kakao16/KiCad9_Projects/XMOS_demo/doc/XMOS_demo.png

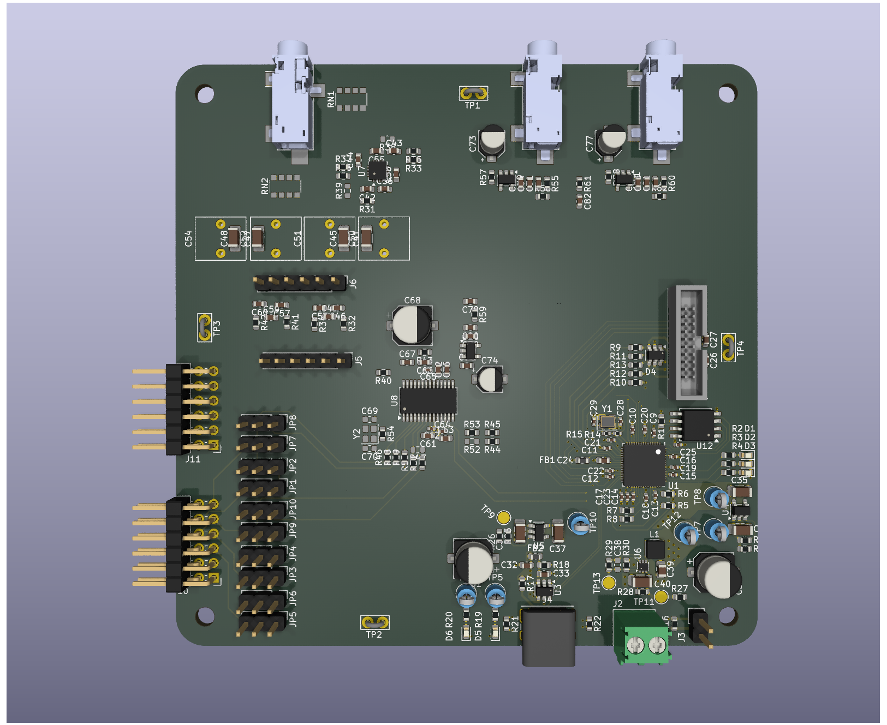
XMOS_demo/doc/XMOS_demo.png
