kakao16/KiCad9_Projects/XMOS_demo/sim/audio_out.asc

C1: cap; 470p
C2: cap; 2.7n
C3: cap; 2.7n
C4: cap; 470n
C5: cap; 470n
C6: cap; 2.7n
C7: cap; 2.7n
C8: cap; 470p
C9: cap; 2µ2
C10: cap; 2µ2
R1: res; 634R
R2: res; 634R
R3: res; 10k
R4: res; 10k
R5: res; 20k
R6: res; 20k
R7: res; 1k
R8: res; 634R
R9: res; 634R
R10: res; 10k
R11: res; 10k
R12: res; 20k
R13: res; 20k
R14: res; 1k
U1: UniversalOpAmp
U2: UniversalOpAmp
V1: voltage; ""; AC 1V
V2: voltage; 2.5V
V3: voltage; 5V
V4: voltage; ""; AC 1V
V5: voltage; 2.5V
Named nets: 0, P5V0, OUT1, OUT2
.ac dec 200 1 100k
Simplified AC simulation of analog output stage of XMOS_demo PCB
