kakao16/KiCad9_Projects/XMOS_demo/XMOS_demo.kicad_pcb

## KiCad design XMOS_demo/XMOS_demo.kicad_pcb (2026-10-02)

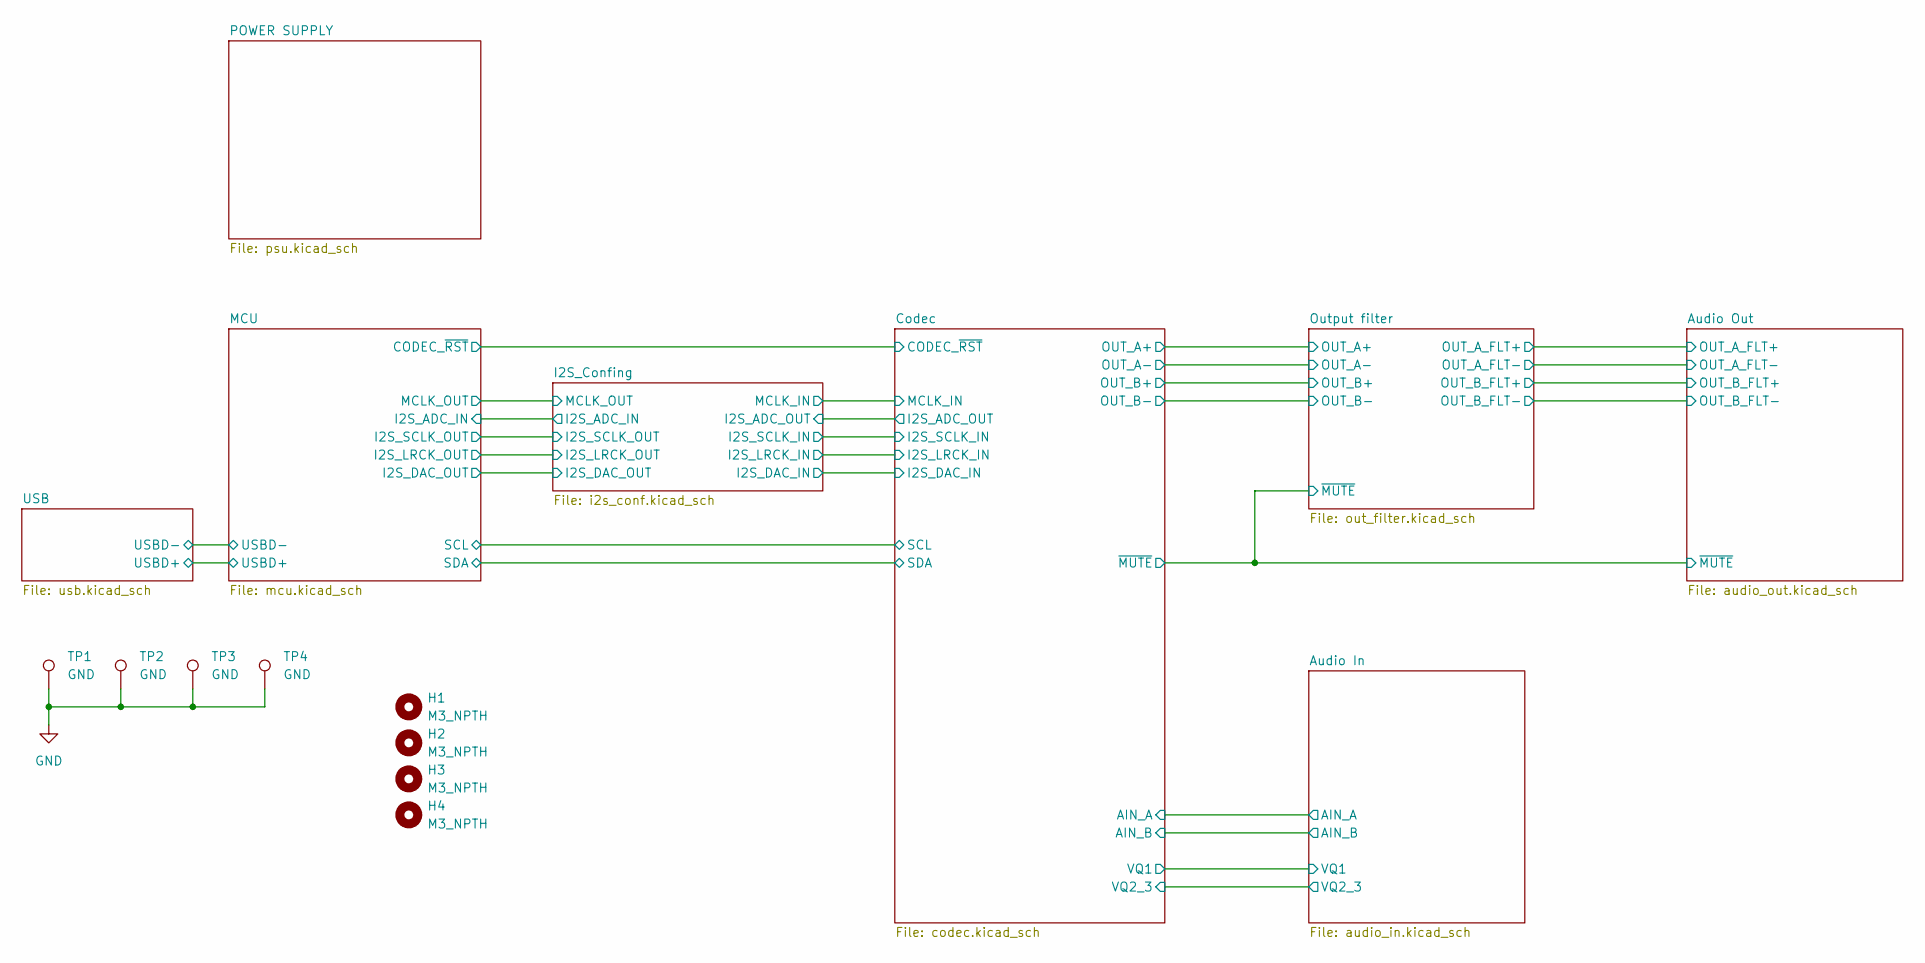
[picture p17: schematic XMOS_demo.kicad_sch, USB Sound Card Top Level]

Parts:
H1, H2, H3, H4: M3_NPTH; MountingHole_3.2mm_M3
TP1, TP2, TP3, TP4: GND; TestPoint_Bridge_Pitch2.54mm_Drill1.0mm

Connections:
GND: TP1.1, TP2.1, TP3.1, TP4.1; also elsewhere on the board

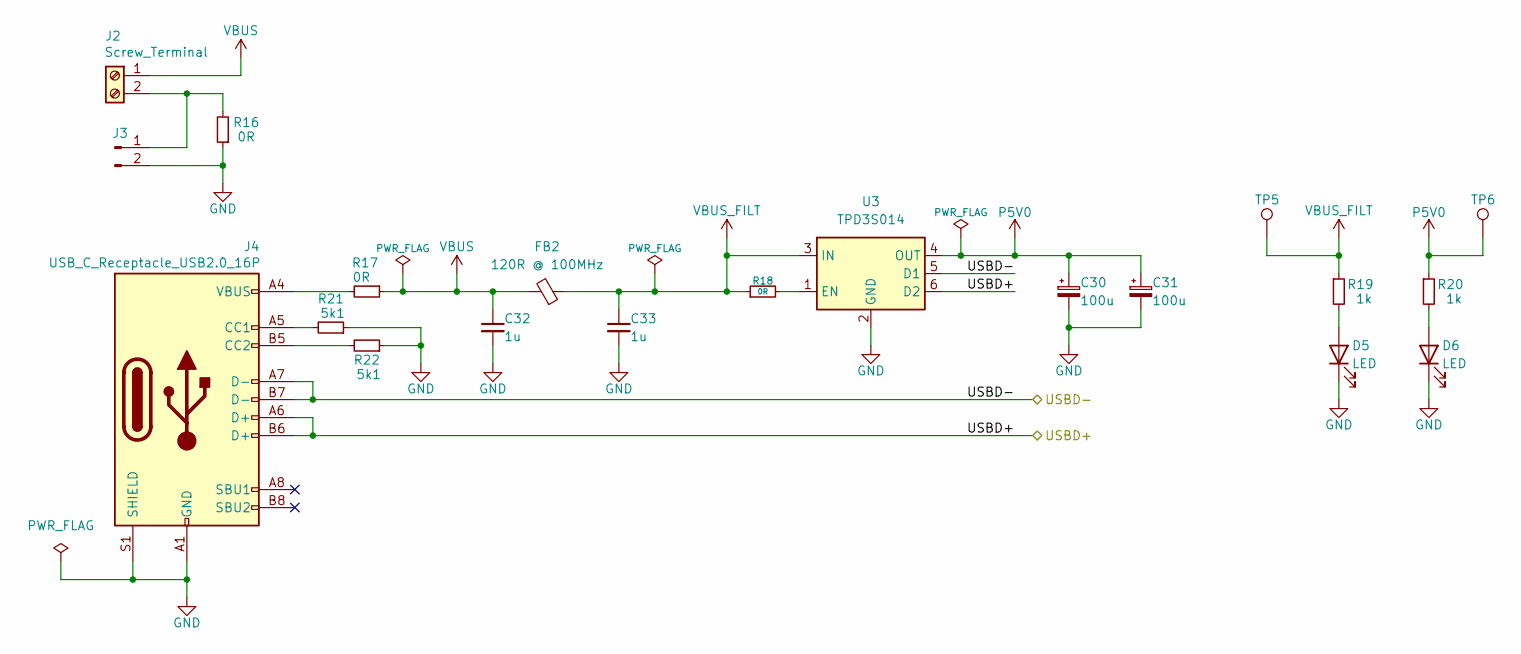
[picture p18: schematic usb.kicad_sch, USB Sound Card USB Port]

Parts:
C30, C31: 100u; CP_Elec_6.3x5.7
C32, C33: 1u; C_0603_1608Metric; Max Voltage 16V
D5, D6: LED; LED_0603_1608Metric
FB2: 120R @ 100MHz; L_0603_1608Metric; MPN MI0603M121R-10
J2: Screw_Terminal; TerminalBlock_Phoenix_PT-1,5-2-3.5-H_1x02_P3.50mm_Horizontal
J3: Conn_01x02_Pin; PinHeader_1x02_P2.54mm_Vertical
J4: USB_C_Receptacle_USB2.0_16P; USB_C_Receptacle_GCT_USB4085
R16, R17, R18: 0R; R_0603_1608Metric
R19, R20: 1k; R_0603_1608Metric
R21, R22: 5k1; R_0603_1608Metric
TP5, TP6: TestPoint; TestPoint_Keystone_5005-5009_Compact
U3: TPD3S014; SOT-23-6; MPN TPD3S014DBVR

Connections:
/USB/USBD+: J4.A6 (D+), J4.B6 (D+), U3.6 (D2); also elsewhere on the board
/USB/USBD-: J4.A7 (D-), J4.B7 (D-), U3.5 (D1); also elsewhere on the board
GND: C30.2, C31.2, C32.2, C33.2, D5.1 (K), D6.1 (K), J3.2, J4.A1 (GND), J4.A12 (GND), J4.B1 (GND), J4.B12 (GND), J4.S1 (SHIELD), R16.1, R21.1, R22.1, U3.2 (GND); also elsewhere on the board
unnamed: D5.2 (A), R19.2
unnamed: D6.2 (A), R20.2
unnamed: J2.2, J3.1, R16.2
unnamed: J4.A5 (CC1), R21.2
unnamed: J4.B5 (CC2), R22.2
unnamed: J4.A4 (VBUS), J4.A9 (VBUS), J4.B4 (VBUS), J4.B9 (VBUS), R17.2
unnamed: R18.2, U3.1 (EN)
P5V0: C30.1, C31.1, R20.1, TP6.1, U3.4 (OUT); also elsewhere on the board
VBUS: C32.1, FB2.2, J2.1, R17.1
VBUS_FILT: C33.1, FB2.1, R18.1, R19.1, TP5.1, U3.3 (IN)

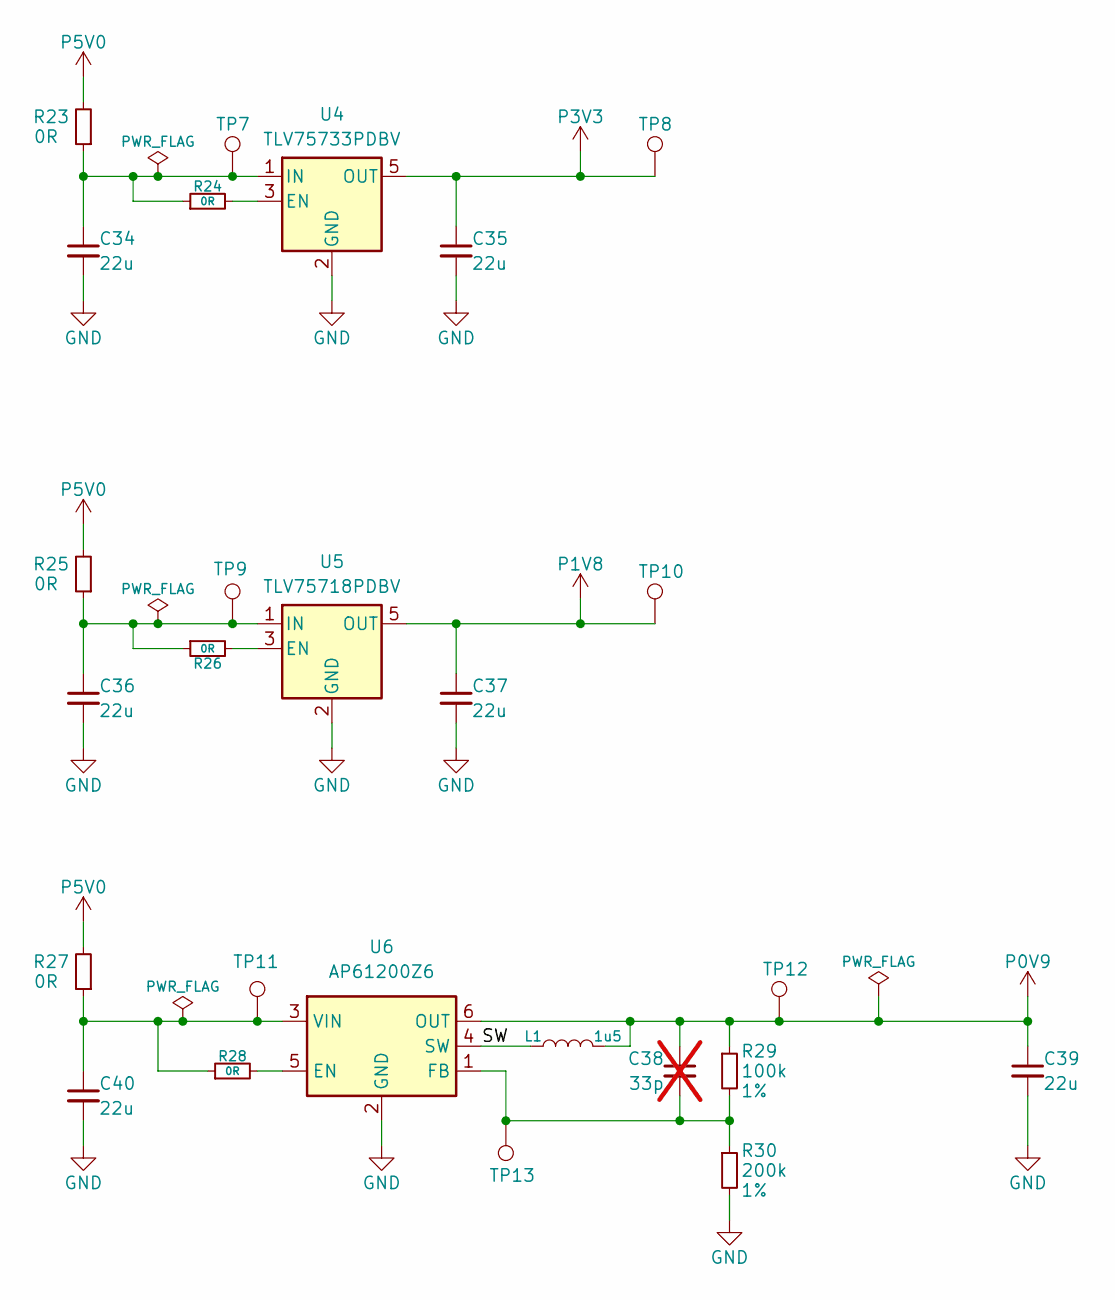
[picture p19: schematic psu.kicad_sch, USB Sound Card Power Supply]

Parts:
C34, C35, C36, C37, C40: 22u; C_1206_3216Metric; Max Voltage 16V
C38: 33p; C_0603_1608Metric; Max Voltage 10V; not fitted
C39: 22u; C_0805_2012Metric; Max Voltage 10V
L1: 1u5; L_Abracon_ASPI-3012S_3D_Simple; MPN ASPI-3012S-1R5N-T
R23, R24, R25, R26, R27, R28: 0R; R_0603_1608Metric
R29: 100k; R_0603_1608Metric; Tolerance 1%
R30: 200k; R_0603_1608Metric; Tolerance 1%
TP7, TP9, TP11, TP13: TestPoint; TestPoint_Pad_D2.0mm
TP8, TP10, TP12: TestPoint; TestPoint_Keystone_5005-5009_Compact
U4: TLV75733PDBV; SOT-23-5
U5: TLV75718PDBV; SOT-23-5
U6: AP61200Z6; SOT-563

Connections:
/POWER SUPPLY/SW: L1.1, U6.4 (SW)
GND: C34.2, C35.2, C36.2, C37.2, C39.2, C40.2, R30.2, U4.2 (GND), U5.2 (GND), U6.2 (GND); also elsewhere on the board
unnamed: R24.2, U4.3 (EN)
unnamed: C34.1, R23.1, R24.1, TP7.1, U4.1 (IN)
unnamed: R26.2, U5.3 (EN)
unnamed: C36.1, R25.1, R26.1, TP9.1, U5.1 (IN)
unnamed: R28.2, U6.5 (EN)
unnamed: C38.2, R29.2, R30.1, TP13.1, U6.1 (FB)
unnamed: C40.1, R27.1, R28.1, TP11.1, U6.3 (VIN)
P0V9: C38.1, C39.1, L1.2, R29.1, TP12.1, U6.6 (OUT); also elsewhere on the board
P1V8: C37.1, TP10.1, U5.5 (OUT); also elsewhere on the board
P3V3: C35.1, TP8.1, U4.5 (OUT); also elsewhere on the board
P5V0: R23.2, R25.2, R27.2; also elsewhere on the board

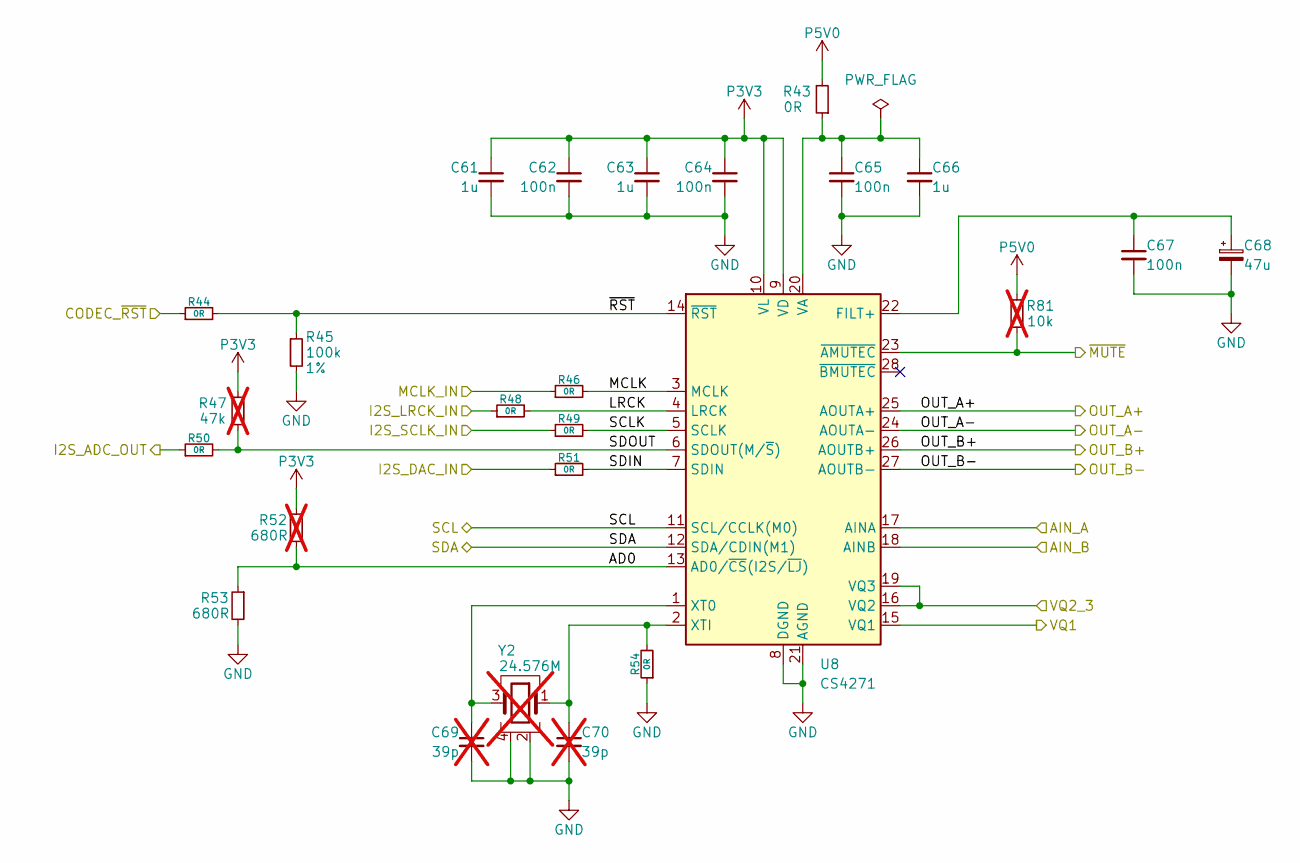
[picture p20: schematic codec.kicad_sch, USB Sound Card Audio Codec]

Parts:
C61, C63, C66: 1u; C_0603_1608Metric; Max Voltage 16V
C62, C64, C65: 100n; C_0402_1005Metric; Max Voltage 16V
C67: 100n; C_0603_1608Metric; Max Voltage 16V
C68: 47u; CP_Elec_6.3x5.7
C69, C70: 39p; C_0603_1608Metric; Max Voltage 10V; not fitted
R43, R44, R46, R48, R49, R50, R51, R54: 0R; R_0603_1608Metric
R45: 100k; R_0603_1608Metric; Tolerance 1%
R47: 47k; R_0603_1608Metric; not fitted
R52: 680R; R_0603_1608Metric; not fitted
R53: 680R; R_0603_1608Metric
R81: 10k; R_0603_1608Metric; not fitted
U8: CS4271; TSSOP-28_4.4x9.7mm_P0.65mm
Y2: 24.576M; Crystal_SMD_2520-4Pin_2.5x2.0mm; not fitted

Connections:
/Audio In/AIN_A: U8.17 (AINA); also elsewhere on the board
/Audio In/AIN_B: U8.18 (AINB); also elsewhere on the board
/Audio In/VQ1: U8.15 (VQ1); also elsewhere on the board
/Audio In/VQ2_3: U8.16 (VQ2), U8.19 (VQ3); also elsewhere on the board
/Audio Out/~MUTE: R81.2, U8.23 (~AMUTEC); also elsewhere on the board
/Codec/AD0: R52.2, R53.1, U8.13 (AD0/~CS(I2S/~LJ))
/Codec/I2S_ADC_OUT: R50.1; also elsewhere on the board
/Codec/I2S_DAC_IN: R51.1; also elsewhere on the board
/Codec/I2S_LRCK_IN: R48.1; also elsewhere on the board
/Codec/I2S_SCLK_IN: R49.1; also elsewhere on the board
/Codec/LRCK: R48.2, U8.4 (LRCK)
/Codec/MCLK: R46.2, U8.3 (MCLK)
/Codec/MCLK_IN: R46.1; also elsewhere on the board
/Codec/OUT_A+: U8.25 (AOUTA+); also elsewhere on the board
/Codec/OUT_A-: U8.24 (AOUTA-); also elsewhere on the board
/Codec/OUT_B+: U8.26 (AOUTB+); also elsewhere on the board
/Codec/OUT_B-: U8.27 (AOUTB-); also elsewhere on the board
/Codec/SCL: U8.11 (SCL/CCLK(M0)); also elsewhere on the board
/Codec/SCLK: R49.2, U8.5 (SCLK)
/Codec/SDA: U8.12 (SDA/CDIN(M1)); also elsewhere on the board
/Codec/SDIN: R51.2, U8.7 (SDIN)
/Codec/SDOUT: R47.2, R50.2, U8.6 (SDOUT(M/~S))
/Codec/~RST: R44.2, R45.1, U8.14 (~RST)
/MCU/CODEC_~RST: R44.1; also elsewhere on the board
GND: C61.2, C62.2, C63.2, C64.2, C65.2, C66.2, C67.2, C68.2, C69.2, C70.2, R45.2, R53.2, R54.1, U8.8 (DGND), U8.21 (AGND), Y2.2 (G), Y2.4 (G); also elsewhere on the board
unnamed: C67.1, C68.1, U8.22 (FILT+)
unnamed: C65.1, C66.1, R43.1, U8.20 (VA)
unnamed: C69.1, U8.1 (XT0), Y2.3
unnamed: C70.1, R54.2, U8.2 (XTI), Y2.1
P3V3: C61.1, C62.1, C63.1, C64.1, R47.1, R52.1, U8.9 (VD), U8.10 (VL); also elsewhere on the board
P5V0: R43.2, R81.1; also elsewhere on the board

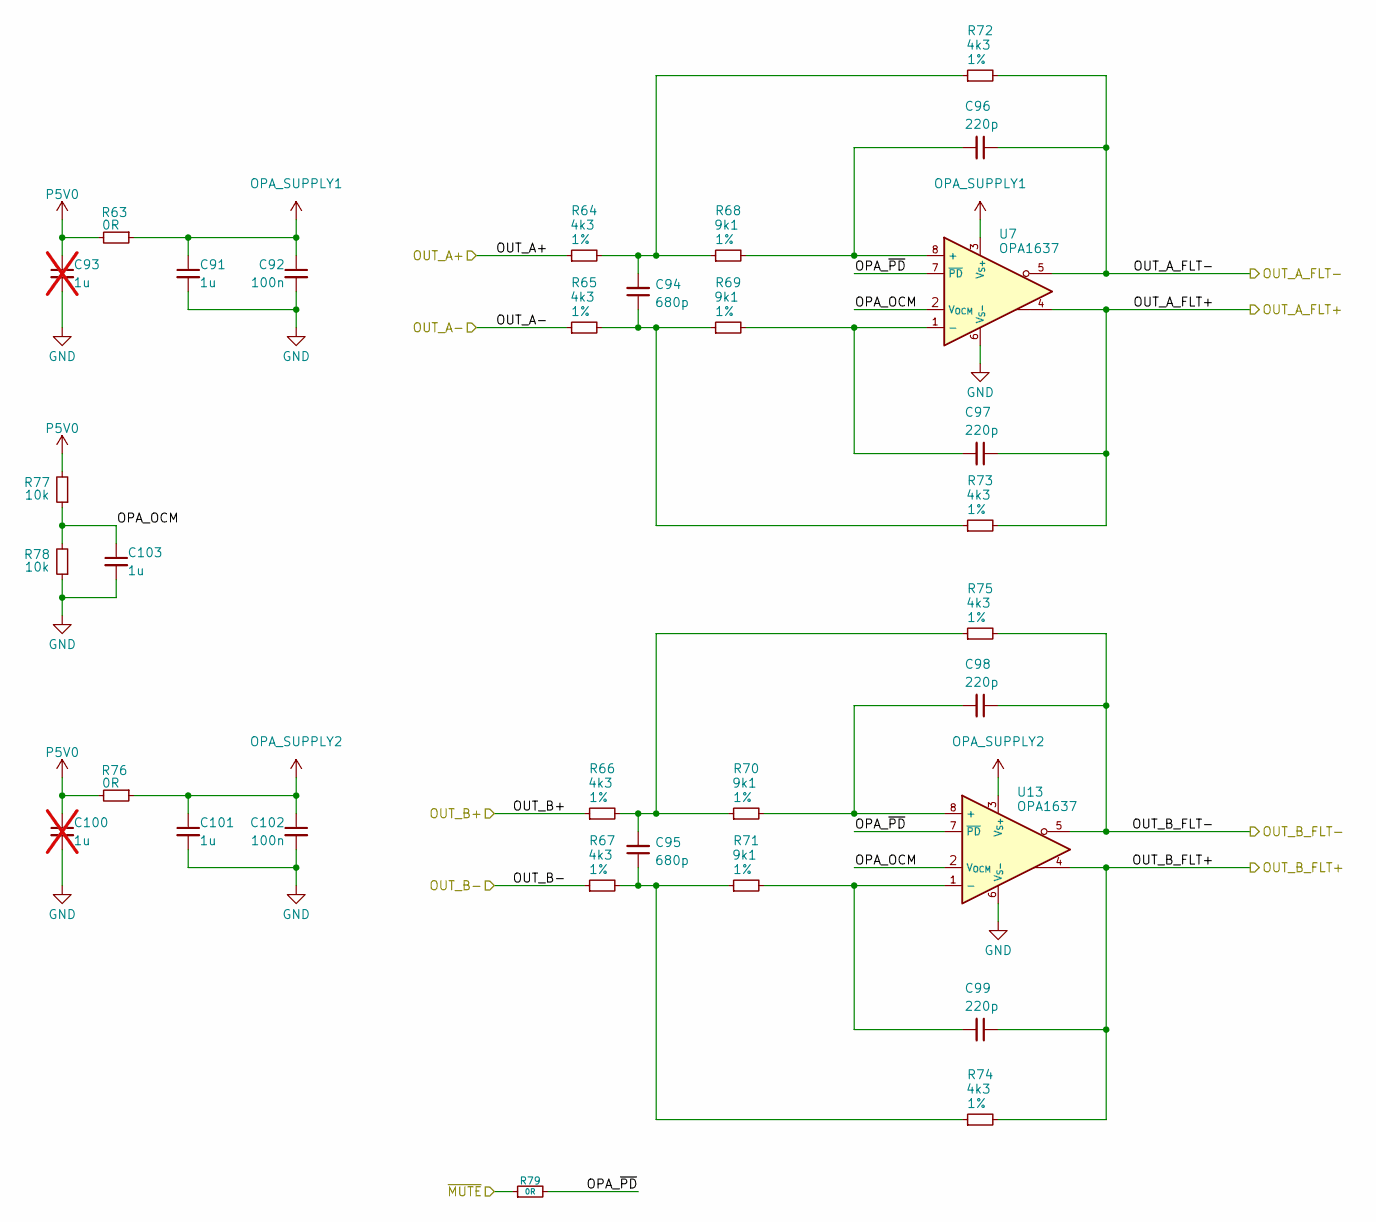
[picture p21: schematic out_filter.kicad_sch]

Parts:
C91, C101, C103: 1u; C_0603_1608Metric; Max Voltage 16V
C92, C102: 100n; C_0402_1005Metric; Max Voltage 16V
C93, C100: 1u; C_0603_1608Metric; Max Voltage 16V; not fitted
C94, C95: 680p; C_0603_1608Metric; Max Voltage 25V
C96, C97, C98, C99: 220p; C_0603_1608Metric; Max Voltage 25V
R63, R76, R79: 0R; R_0603_1608Metric
R64, R65, R66, R67, R72, R73, R74, R75: 4k3; R_0603_1608Metric; Tolerance 1%
R68, R69, R70, R71: 9k1; R_0603_1608Metric; Tolerance 1%
R77, R78: 10k; R_0603_1608Metric
U7, U13: OPA1637; VSSOP-8_3x3mm_P0.65mm; MPN OPA1637DGKR

Connections:
/Audio Out/OUT_A_FLT+: C97.1, R73.2, U7.4; also elsewhere on the board
/Audio Out/OUT_A_FLT-: C96.1, R72.2, U7.5; also elsewhere on the board
/Audio Out/OUT_B_FLT+: C99.1, R74.2, U13.4; also elsewhere on the board
/Audio Out/OUT_B_FLT-: C98.1, R75.2, U13.5; also elsewhere on the board
/Audio Out/~MUTE: R79.1; also elsewhere on the board
/Codec/OUT_A+: R64.1; also elsewhere on the board
/Codec/OUT_A-: R65.1; also elsewhere on the board
/Codec/OUT_B+: R66.1; also elsewhere on the board
/Codec/OUT_B-: R67.1; also elsewhere on the board
/Output filter/OPA_OCM: C103.1, R77.1, R78.2, U7.2 (V_{OCM}), U13.2 (V_{OCM})
/Output filter/OPA_~PD: R79.2, U7.7 (~PD), U13.7 (~PD)
GND: C91.2, C92.2, C93.2, C100.2, C101.2, C102.2, C103.2, R78.1, U7.6 (V_{S-}), U13.6 (V_{S-}); also elsewhere on the board
unnamed: C94.1, R65.2, R69.1, R73.1
unnamed: C94.2, R64.2, R68.1, R72.1
unnamed: C95.1, R67.2, R71.1, R74.1
unnamed: C95.2, R66.2, R70.1, R75.1
unnamed: C96.2, R68.2, U7.8 (+)
unnamed: C97.2, R69.2, U7.1 (-)
unnamed: C98.2, R70.2, U13.8 (+)
unnamed: C99.2, R71.2, U13.1 (-)
OPA_SUPPLY1: C91.1, C92.1, R63.1, U7.3 (V_{S+})
OPA_SUPPLY2: C101.1, C102.1, R76.1, U13.3 (V_{S+})
P5V0: C93.1, C100.1, R63.2, R76.2, R77.2; also elsewhere on the board

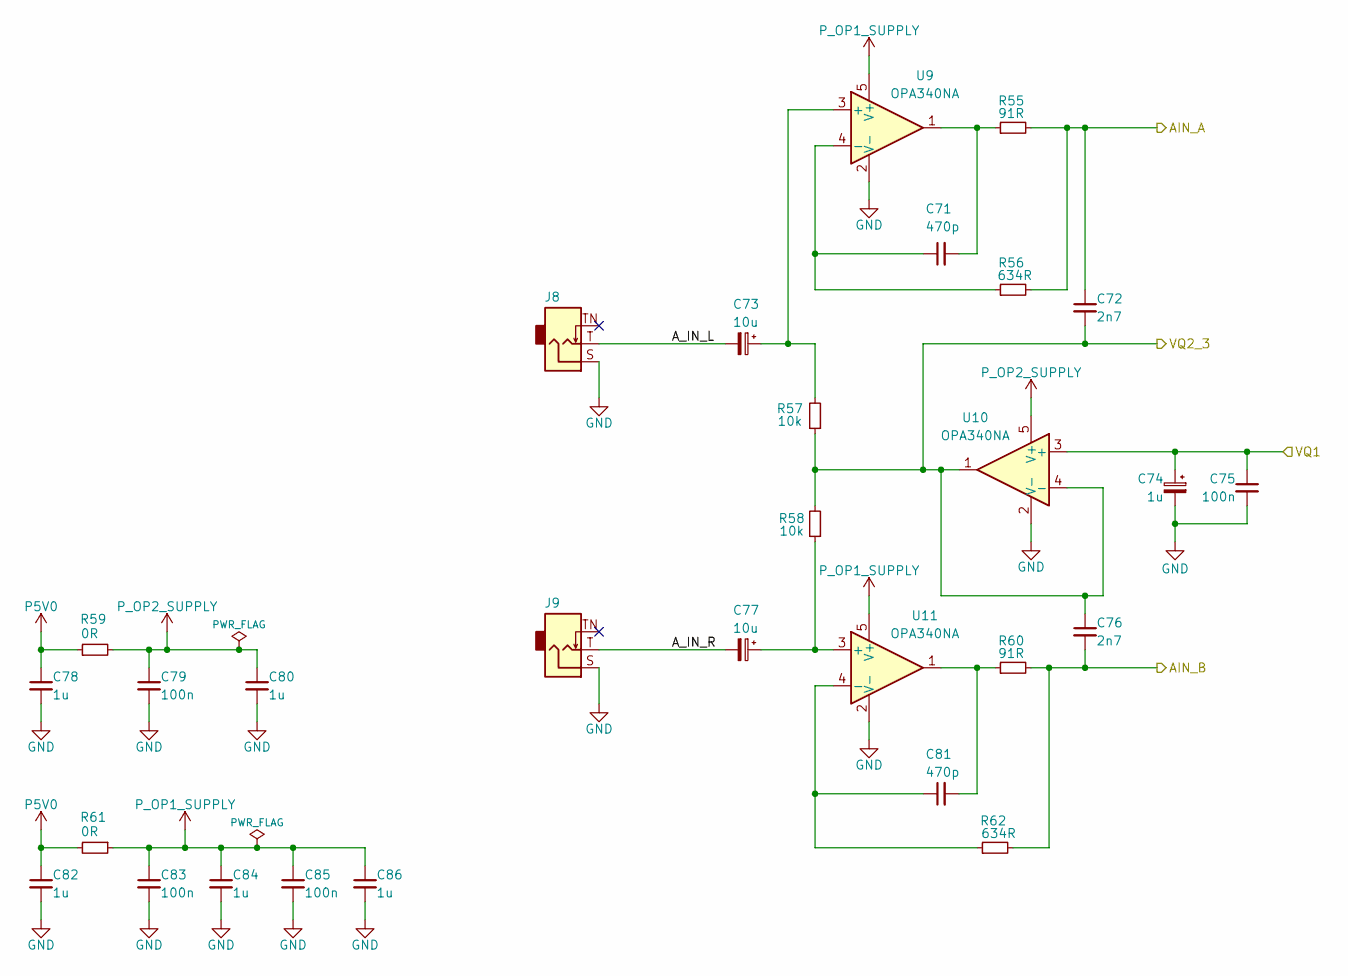
[picture p22: schematic audio_in.kicad_sch, USB Sound Card Audio Input]

Parts:
C71, C81: 470p; C_0603_1608Metric; Max Voltage 25V
C72, C76: 2n7; C_0603_1608Metric; Max Voltage 25V
C73, C77: 10u; CP_Elec_4x5.4
C74: 1u; CP_Elec_4x5.4
C75, C79, C83, C85: 100n; C_0603_1608Metric; Max Voltage 16V
C78, C80, C82, C84, C86: 1u; C_0603_1608Metric; Max Voltage 16V
J8, J9: AudioJack2_SwitchT; Jack_3.5mm_CUI_MJ-3523-SMT-TR_Horizontal; MPN MJ-3523-SMT-TR
R55, R60: 91R; R_0603_1608Metric
R56, R62: 634R; R_0603_1608Metric
R57, R58: 10k; R_0603_1608Metric
R59, R61: 0R; R_0603_1608Metric
U9, U10, U11: OPA340NA; SOT-23-5

Connections:
/Audio In/AIN_A: C72.1, R55.2, R56.2; also elsewhere on the board
/Audio In/AIN_B: C76.2, R60.2, R62.2; also elsewhere on the board
/Audio In/A_IN_L: C73.2, J8.T
/Audio In/A_IN_R: C77.2, J9.T
/Audio In/VQ1: C74.1, C75.1, U10.3 (+); also elsewhere on the board
/Audio In/VQ2_3: C72.2, C76.1, R57.1, R58.2, U10.1, U10.4 (-); also elsewhere on the board
GND: C74.2, C75.2, C78.2, C79.2, C80.2, C82.2, C83.2, C84.2, C85.2, C86.2, J8.S, J9.S, U9.2 (V-), U10.2 (V-), U11.2 (V-); also elsewhere on the board
unnamed: C71.2, R55.1, U9.1
unnamed: C81.2, R60.1, U11.1
unnamed: C73.1, R57.2, U9.3 (+)
unnamed: C71.1, R56.1, U9.4 (-)
unnamed: C77.1, R58.1, U11.3 (+)
unnamed: C81.1, R62.1, U11.4 (-)
P5V0: C78.1, C82.1, R59.1, R61.2; also elsewhere on the board
P_OP1_SUPPLY: C83.1, C84.1, C85.1, C86.1, R61.1, U9.5 (V+), U11.5 (V+)
P_OP2_SUPPLY: C79.1, C80.1, R59.2, U10.5 (V+)

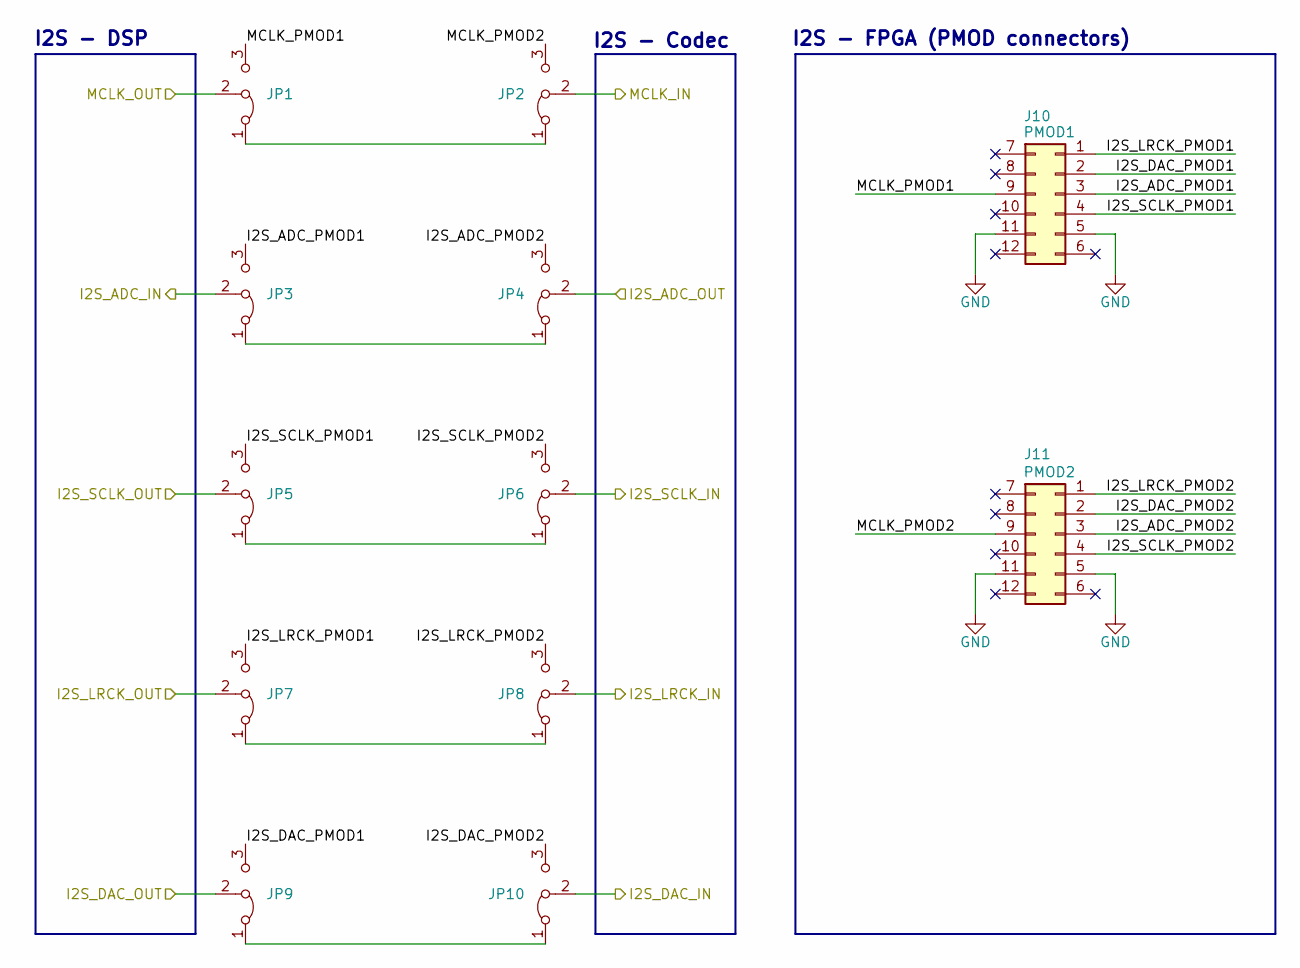
[picture p23: schematic i2s_conf.kicad_sch, USB Sound Card I2S Configuration]

Parts:
J10, J11: Conn_PMOD_02x06; PMOD_PinHeader_2x06_P2.54mm_Horizontal
JP1, JP2, JP3, JP4, JP5, JP6, JP7, JP8, JP9, JP10: Jumper_3_Bridged12; PinHeader_1x03_P2.54mm_Vertical

Connections:
/Codec/I2S_ADC_OUT: JP4.2 (C); also elsewhere on the board
/Codec/I2S_DAC_IN: JP10.2 (C); also elsewhere on the board
/Codec/I2S_LRCK_IN: JP8.2 (C); also elsewhere on the board
/Codec/I2S_SCLK_IN: JP6.2 (C); also elsewhere on the board
/Codec/MCLK_IN: JP2.2 (C); also elsewhere on the board
/I2S_Confing/I2S_ADC_PMOD1: J10.3, JP3.3 (B)
/I2S_Confing/I2S_ADC_PMOD2: J11.3, JP4.3 (B)
/I2S_Confing/I2S_DAC_PMOD1: J10.2, JP9.3 (B)
/I2S_Confing/I2S_DAC_PMOD2: J11.2, JP10.3 (B)
/I2S_Confing/I2S_LRCK_PMOD1: J10.1, JP7.3 (B)
/I2S_Confing/I2S_LRCK_PMOD2: J11.1, JP8.3 (B)
/I2S_Confing/I2S_SCLK_PMOD1: J10.4, JP5.3 (B)
/I2S_Confing/I2S_SCLK_PMOD2: J11.4, JP6.3 (B)
/I2S_Confing/MCLK_PMOD1: J10.9, JP1.3 (B)
/I2S_Confing/MCLK_PMOD2: J11.9, JP2.3 (B)
/MCU/I2S_ADC_IN: JP3.2 (C); also elsewhere on the board
/MCU/I2S_DAC_OUT: JP9.2 (C); also elsewhere on the board
/MCU/I2S_LRCK_OUT: JP7.2 (C); also elsewhere on the board
/MCU/I2S_SCLK_OUT: JP5.2 (C); also elsewhere on the board
/MCU/MCLK_OUT: JP1.2 (C); also elsewhere on the board
GND: J10.5, J10.11, J11.5, J11.11; also elsewhere on the board
unnamed: JP1.1 (A), JP2.1 (A)
unnamed: JP3.1 (A), JP4.1 (A)
unnamed: JP5.1 (A), JP6.1 (A)
unnamed: JP7.1 (A), JP8.1 (A)
unnamed: JP9.1 (A), JP10.1 (A)

Notes on the sheet:
I2S - DSP
I2S - FPGA (PMOD connectors)
I2S - Codec

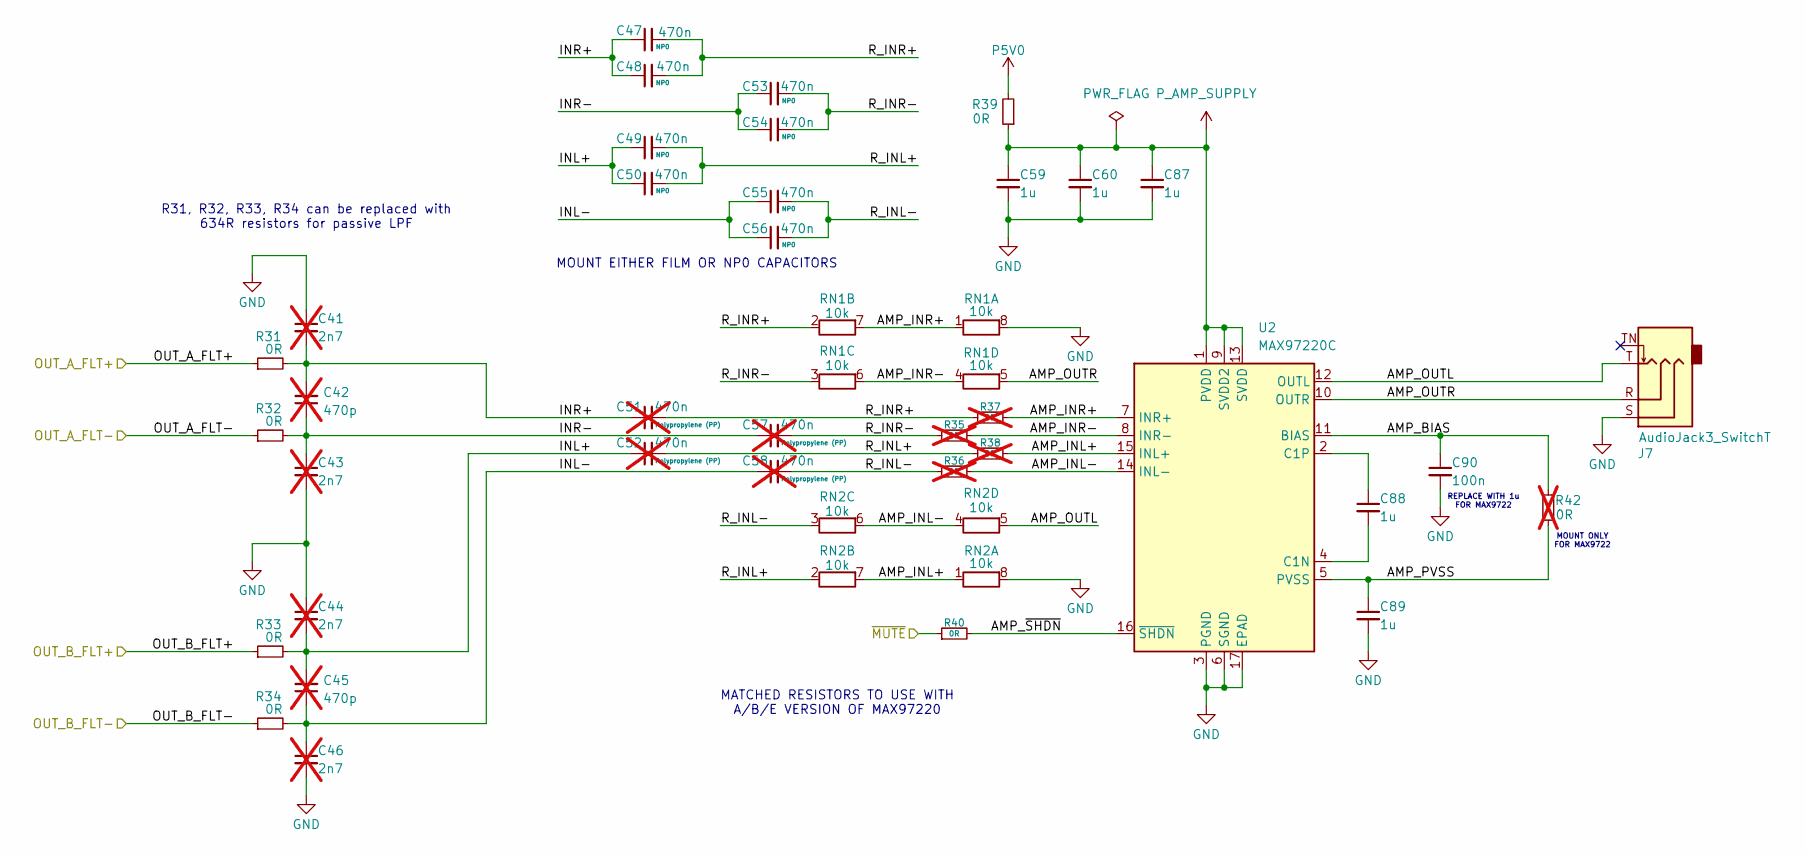
[picture p24: schematic audio_out.kicad_sch, USB Sound Card Audio Output Amplifier]

Parts:
C41, C43, C44, C46: 2n7; C_0603_1608Metric; Max Voltage 25V; not fitted
C42, C45: 470p; C_0603_1608Metric; Max Voltage 25V; not fitted
C47, C48, C49, C50, C53, C54, C55, C56: 470n; C_1206_3216Metric_Pad1.33x1.80mm_HandSolder; Max Voltage 25V; MPN GRM31C5C1E474JE01L
C51, C52, C57, C58: 470n; C_Rect_L7.2mm_W8.5mm_P5.00mm_FKP2_FKP2_MKS2_MKP2; Max Voltage DC 100V; MPN MKP2D034701M00KSSD; not fitted
C59, C60, C87, C88, C89: 1u; C_0603_1608Metric; Max Voltage 16V
C90: 100n; C_0402_1005Metric; Max Voltage 16V
J7: AudioJack3_SwitchT; Jack_3.5mm_CUI_SJ-3523-SMT-TR_Horizontal; MPN SJ-3523-SMT-TR
R31, R32, R33, R34, R39, R40: 0R; R_0603_1608Metric
R35, R36, R37, R38, R42: 0R; R_0603_1608Metric; not fitted
RN1, RN2: 10k; R_Array_Convex_4x0603
U2: MAX97220C; TQFN-16-1EP_3x3mm_P0.5mm_EP1.23x1.23mm_ThermalVias

Connections:
/Audio Out/AMP_BIAS: C90.1, R42.2, U2.11 (BIAS)
/Audio Out/AMP_INL+: R38.2, RN2.1 (R1.1), RN2.7 (R2.2), U2.15 (INL+)
/Audio Out/AMP_INL-: R36.2, RN2.4 (R4.1), RN2.6 (R3.2), U2.14 (INL-)
/Audio Out/AMP_INR+: R37.2, RN1.1 (R1.1), RN1.7 (R2.2), U2.7 (INR+)
/Audio Out/AMP_INR-: R35.2, RN1.4 (R4.1), RN1.6 (R3.2), U2.8 (INR-)
/Audio Out/AMP_OUTL: J7.T, RN2.5 (R4.2), U2.12 (OUTL)
/Audio Out/AMP_OUTR: J7.R, RN1.5 (R4.2), U2.10 (OUTR)
/Audio Out/AMP_PVSS: C89.1, R42.1, U2.5 (PVSS)
/Audio Out/AMP_~SHDN: R40.2, U2.16 (~SHDN)
/Audio Out/INL+: C44.2, C45.2, C49.1, C50.1, C52.1, R33.2
/Audio Out/INL-: C45.1, C46.1, C55.1, C56.1, C58.1, R34.2
/Audio Out/INR+: C41.2, C42.2, C47.1, C48.1, C51.1, R31.2
/Audio Out/INR-: C42.1, C43.1, C53.1, C54.1, C57.1, R32.2
/Audio Out/OUT_A_FLT+: R31.1; also elsewhere on the board
/Audio Out/OUT_A_FLT-: R32.1; also elsewhere on the board
/Audio Out/OUT_B_FLT+: R33.1; also elsewhere on the board
/Audio Out/OUT_B_FLT-: R34.1; also elsewhere on the board
/Audio Out/R_INL+: C49.2, C50.2, C52.2, R38.1, RN2.2 (R2.1)
/Audio Out/R_INL-: C55.2, C56.2, C58.2, R36.1, RN2.3 (R3.1)
/Audio Out/R_INR+: C47.2, C48.2, C51.2, R37.1, RN1.2 (R2.1)
/Audio Out/R_INR-: C53.2, C54.2, C57.2, R35.1, RN1.3 (R3.1)
/Audio Out/~MUTE: R40.1; also elsewhere on the board
GND: C41.1, C43.2, C44.1, C46.2, C59.2, C60.2, C87.2, C89.2, C90.2, J7.S, RN1.8 (R1.2), RN2.8 (R1.2), U2.3 (PGND), U2.6 (SGND), U2.17 (EPAD); also elsewhere on the board
unnamed: C88.2, U2.4 (C1N)
unnamed: C88.1, U2.2 (C1P)
P5V0: R39.2; also elsewhere on the board
P_AMP_SUPPLY: C59.1, C60.1, C87.1, R39.1, U2.1 (PVDD), U2.9 (SVDD2), U2.13 (SVDD)

Notes on the sheet:
R31, R32, R33, R34 can be replaced with 634R resistors for passive LPF
MOUNT EITHER FILM OR NP0 CAPACITORS
MOUNT ONLY FOR MAX9722
MATCHED RESISTORS TO USE WITH A/B/E VERSION OF MAX97220
REPLACE WITH 1u FOR MAX9722
