kakao16/KiCad9_Projects/XMOS_demo/XMOS_demo.kicad_pcb

## KiCad design XMOS_demo/XMOS_demo.kicad_pcb (continued)

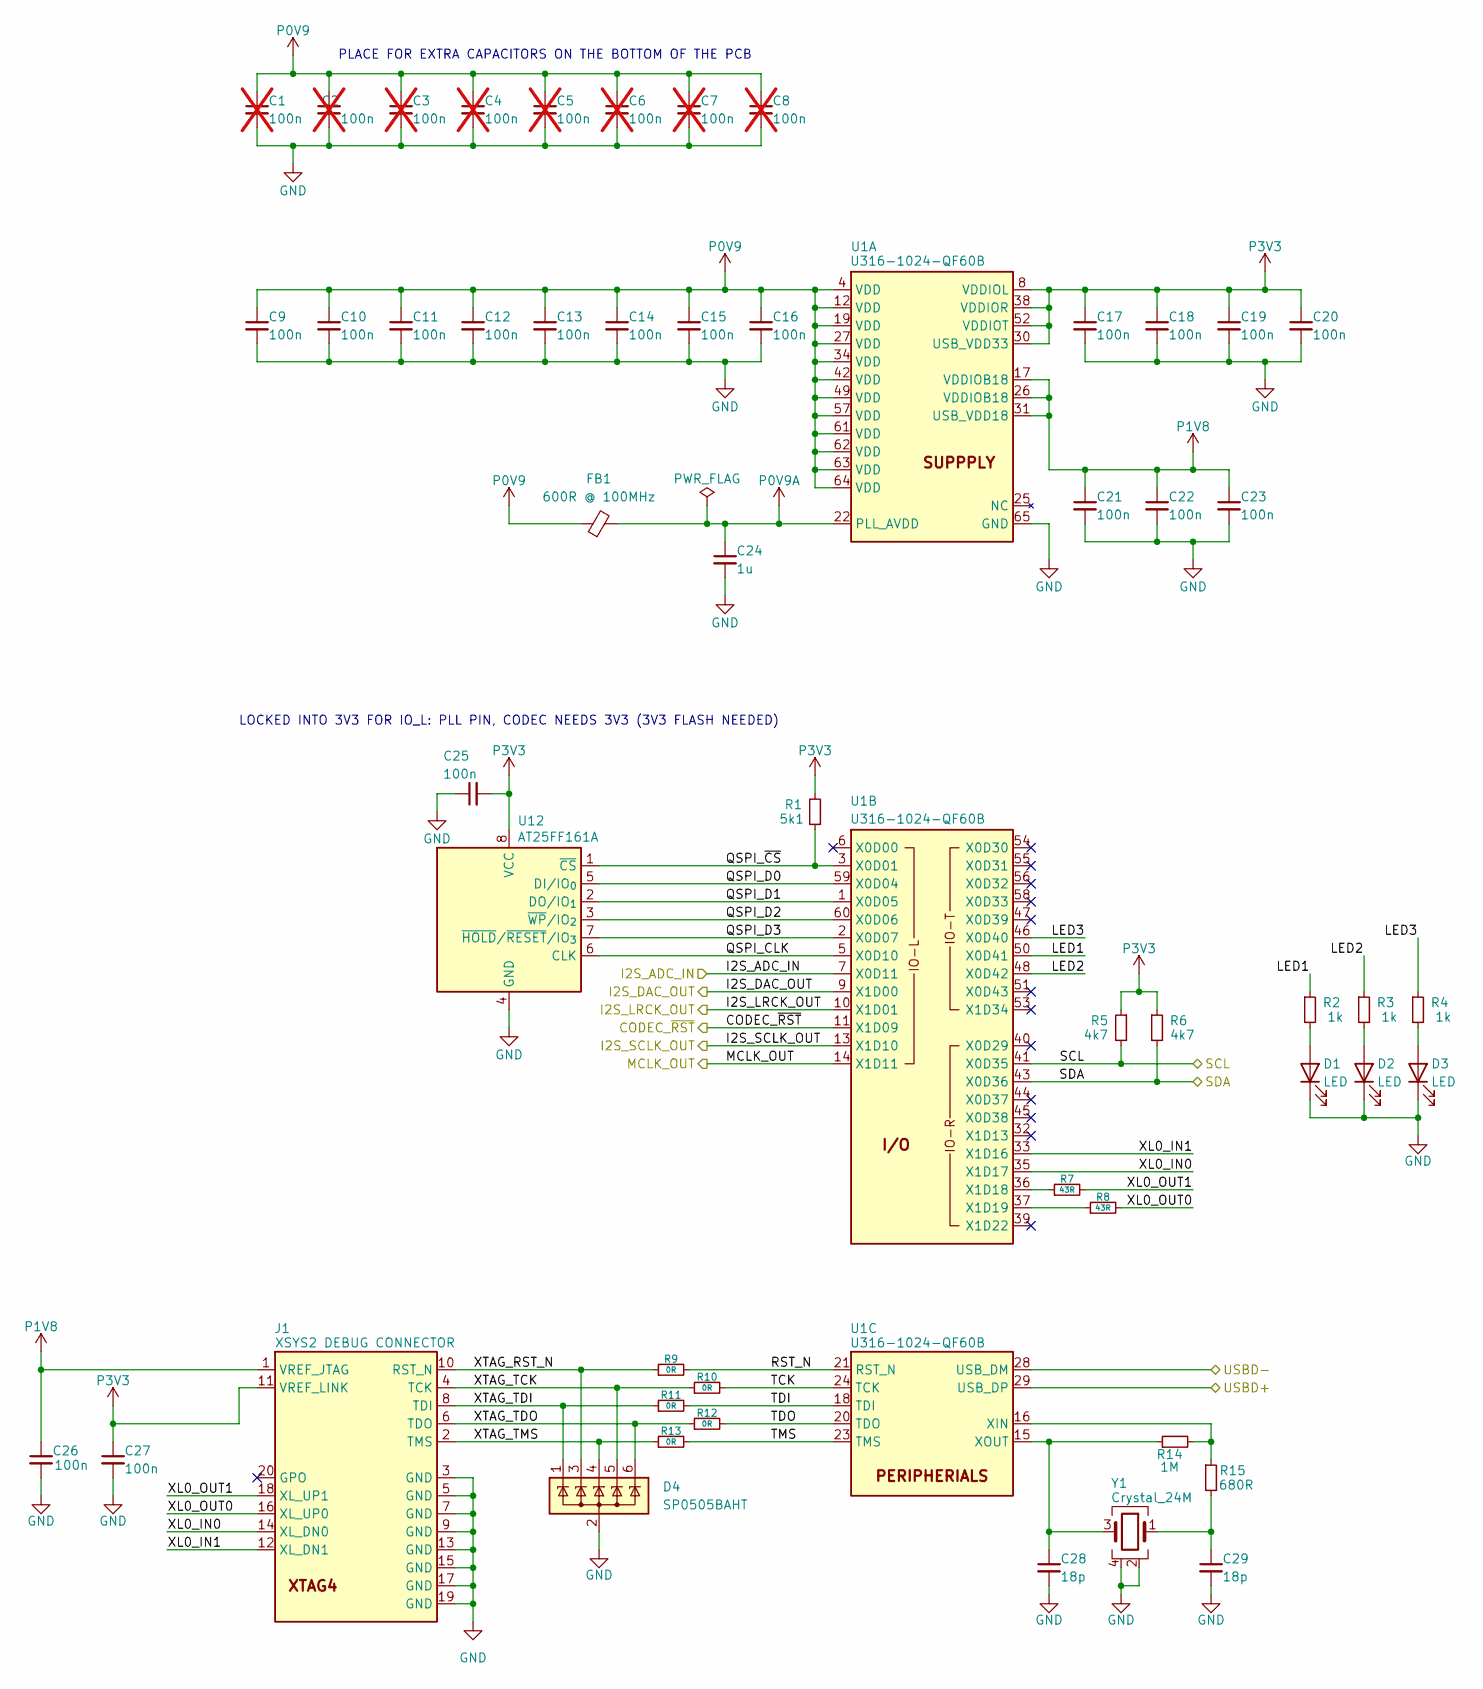
[picture p25: schematic mcu.kicad_sch, USB Sound Card MCU]

Parts:
C1, C2, C3, C4, C5, C6, C7, C8: 100n; C_0402_1005Metric; Max Voltage 16V; not fitted
C9, C10, C11, C12, C13, C14, C15, C16, C17, C18, C19, C20, C21, C22, C23, C25: 100n; C_0402_1005Metric; Max Voltage 16V
C24: 1u; C_0603_1608Metric; Max Voltage 16V
C26, C27: 100n; C_0603_1608Metric; Max Voltage 16V
C28, C29: 18p; C_0402_1005Metric; Max Voltage 10V
D1, D2, D3: LED; LED_0603_1608Metric
D4: SP0505BAHT; SOT-23-6
FB1: 600R @ 100MHz; L_0603_1608Metric; MPN MI0603J601R-10
J1: XSYS2 DEBUG CONNECTOR; IDC-Header_2x10_P1.27mm_Vertical; MPN 20021511-00020T4LF
R1: 5k1; R_0603_1608Metric
R2, R3, R4: 1k; R_0603_1608Metric
R5, R6: 4k7; R_0603_1608Metric
R7, R8: 43R; R_0603_1608Metric
R9, R10, R11, R12, R13: 0R; R_0603_1608Metric
R14: 1M; R_0402_1005Metric
R15: 680R; R_0402_1005Metric
U1: U316-1024-QF60B; QFN-60_7x7mm_P0.4mm_EP_ThermalVias_PowerBars; MPN XU316-1024-QF60B-C24
U12: AT25FF161A; SOIC-8_5.3x5.3mm_P1.27mm; MPN AT25FF161A-SHL-T
Y1: Crystal_24M; Crystal_SMD_2520-4Pin_2.5x2.0mm; MPN STDCSW2-24M

Connections:
/Codec/SCL: R5.2, U1.41 (X0D35); also elsewhere on the board
/Codec/SDA: R6.2, U1.43 (X0D36); also elsewhere on the board
/MCU/CODEC_~RST: U1.11 (X1D09); also elsewhere on the board
/MCU/I2S_ADC_IN: U1.7 (X0D11); also elsewhere on the board
/MCU/I2S_DAC_OUT: U1.9 (X1D00); also elsewhere on the board
/MCU/I2S_LRCK_OUT: U1.10 (X1D01); also elsewhere on the board
/MCU/I2S_SCLK_OUT: U1.13 (X1D10); also elsewhere on the board
/MCU/LED1: R2.1, U1.50 (X0D41)
/MCU/LED2: R3.1, U1.48 (X0D42)
/MCU/LED3: R4.1, U1.46 (X0D40)
/MCU/MCLK_OUT: U1.14 (X1D11); also elsewhere on the board
/MCU/QSPI_CLK: U1.5 (X0D10), U12.6 (CLK)
/MCU/QSPI_D0: U1.59 (X0D04), U12.5 (DI/IO_{0})
/MCU/QSPI_D1: U1.1 (X0D05), U12.2 (DO/IO_{1})
/MCU/QSPI_D2: U1.60 (X0D06), U12.3 (~WP/IO_{2})
/MCU/QSPI_D3: U1.2 (X0D07), U12.7 (~HOLD/~RESET/IO_{3})
/MCU/QSPI_~CS: R1.1, U1.3 (X0D01), U12.1 (~CS)
/MCU/RST_N: R9.2, U1.21 (RST_N)
/MCU/TCK: R10.2, U1.24 (TCK)
/MCU/TDI: R11.2, U1.18 (TDI)
/MCU/TDO: R12.2, U1.20 (TDO)
/MCU/TMS: R13.2, U1.23 (TMS)
/MCU/XL0_IN0: J1.14 (XL_DN0), U1.35 (X1D17)
/MCU/XL0_IN1: J1.12 (XL_DN1), U1.33 (X1D16)
/MCU/XL0_OUT0: J1.16 (XL_UP0), R8.2
/MCU/XL0_OUT1: J1.18 (XL_UP1), R7.2
/MCU/XTAG_RST_N: D4.3 (K), J1.10 (RST_N), R9.1
/MCU/XTAG_TCK: D4.5 (K), J1.4 (TCK), R10.1
/MCU/XTAG_TDI: D4.1 (K), J1.8 (TDI), R11.1
/MCU/XTAG_TDO: D4.6 (K), J1.6 (TDO), R12.1
/MCU/XTAG_TMS: D4.4 (K), J1.2 (TMS), R13.1
/USB/USBD+: U1.29 (USB_DP); also elsewhere on the board
/USB/USBD-: U1.28 (USB_DM); also elsewhere on the board
GND: C1.2, C2.2, C3.2, C4.2, C5.2, C6.2, C7.2, C8.2, C9.2, C10.2, C11.2, C12.2, C13.2, C14.2, C15.2, C16.2, C17.2, C18.2, C19.2, C20.2, C21.2, C22.2, C23.2, C24.2, C25.1, C26.2, C27.2, C28.2, C29.2, D1.1 (K), D2.1 (K), D3.1 (K), D4.2 (A), J1.3 (GND), J1.5 (GND), J1.7 (GND), J1.9 (GND), J1.13 (GND), J1.15 (GND), J1.17 (GND), J1.19 (GND), U1.65 (GND), U12.4 (GND), Y1.2 (G), Y1.4 (G); also elsewhere on the board
unnamed: C29.1, R15.2, Y1.1
unnamed: D1.2 (A), R2.2
unnamed: D2.2 (A), R3.2
unnamed: D3.2 (A), R4.2
unnamed: R7.1, U1.36 (X1D18)
unnamed: R8.1, U1.37 (X1D19)
unnamed: R14.2, R15.1, U1.16 (XIN)
unnamed: C28.1, R14.1, U1.15 (XOUT), Y1.3
P0V9: C1.1, C2.1, C3.1, C4.1, C5.1, C6.1, C7.1, C8.1, C9.1, C10.1, C11.1, C12.1, C13.1, C14.1, C15.1, C16.1, FB1.1, U1.4 (VDD), U1.12 (VDD), U1.19 (VDD), U1.27 (VDD), U1.34 (VDD), U1.42 (VDD), U1.49 (VDD), U1.57 (VDD), U1.61 (VDD), U1.62 (VDD), U1.63 (VDD), U1.64 (VDD); also elsewhere on the board
P0V9A: C24.1, FB1.2, U1.22 (PLL_AVDD)
P1V8: C21.1, C22.1, C23.1, C26.1, J1.1 (VREF_JTAG), U1.17 (VDDIOB18), U1.26 (VDDIOB18), U1.31 (USB_VDD18); also elsewhere on the board
P3V3: C17.1, C18.1, C19.1, C20.1, C25.2, C27.1, J1.11 (VREF_LINK), R1.2, R5.1, R6.1, U1.8 (VDDIOL), U1.30 (USB_VDD33), U1.38 (VDDIOR), U1.52 (VDDIOT), U12.8 (VCC); also elsewhere on the board

Notes on the sheet:
PLACE FOR EXTRA CAPACITORS ON THE BOTTOM OF THE PCB
LOCKED INTO 3V3 FOR IO_L: PLL PIN, CODEC NEEDS 3V3 (3V3 FLASH NEEDED)

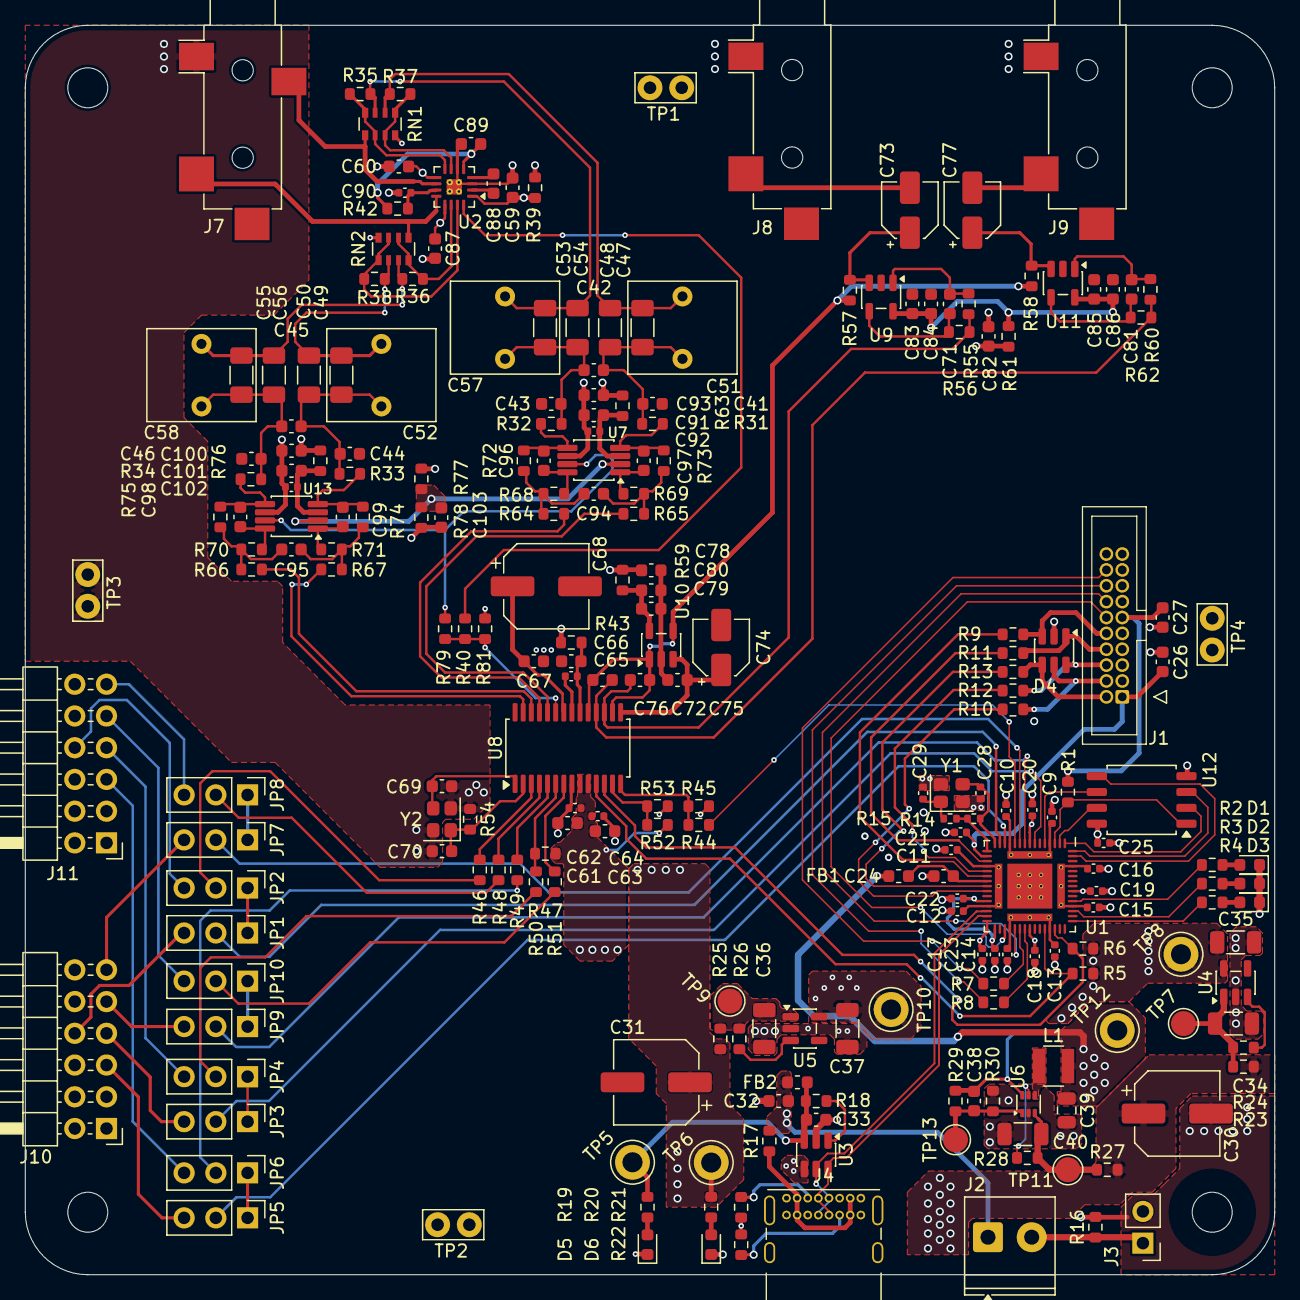
[picture p26: board XMOS_demo.kicad_pcb from above]

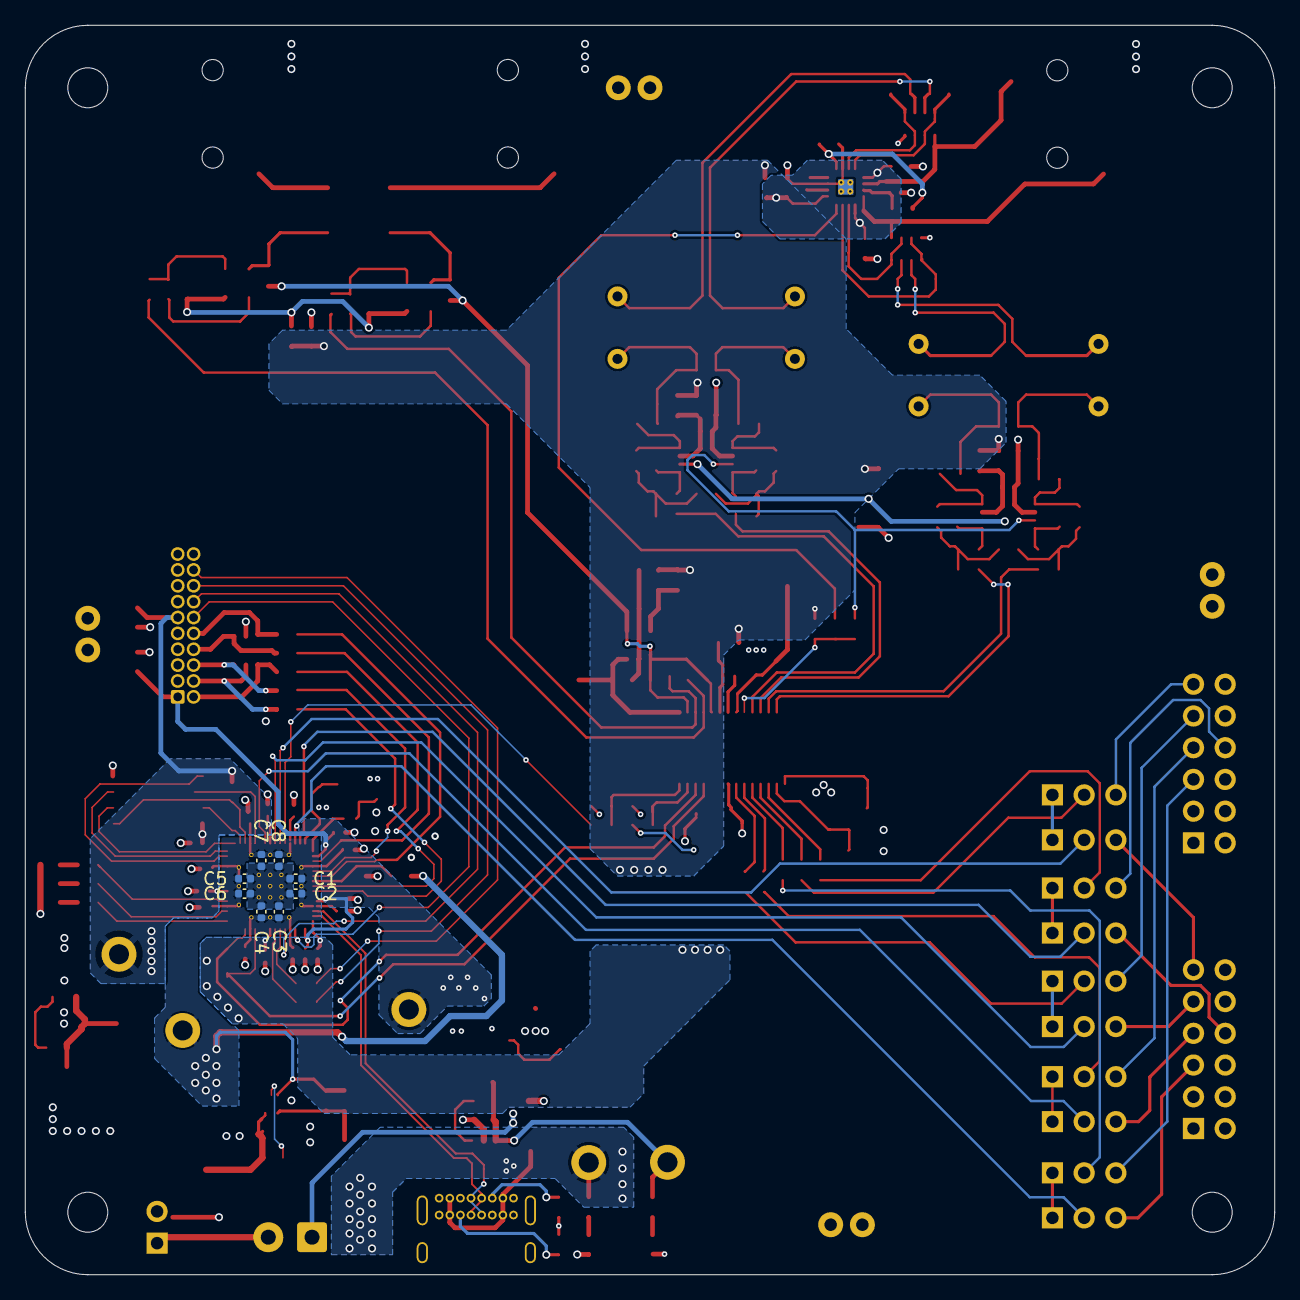
[picture p27: board XMOS_demo.kicad_pcb from below]

Board: 4 copper layers, 100.0 x 100.0 mm, 244 parts (8 on the bottom side), 150 nets.
