kakao16/KiCad9_Projects/(commit log)

2026-03-22 XMOS_demo initial, ignore
    [XMOS_demo.kicad_pcb, XMOS_demo.kicad_sch, mcu.kicad_sch]
2026-03-23 crystal, usb
    [mcu.kicad_sch]
2026-03-25 leds, usb cc lines
    [mcu.kicad_sch]
2026-03-28 usb moved to seperate sch, power supply sch started
    [XMOS_demo.kicad_sch, mcu.kicad_sch, psu.kicad_sch, usb.kicad_sch]
2026-03-29 sch work
    [XMOS_demo.kicad_sch, audio_out.kicad_sch, codec.kicad_sch, mcu.kicad_sch, psu.kicad_sch, usb.kicad_sch]
2026-04-01 Work on audio output amplifier
    [audio_out.kicad_sch]
2026-04-04 Lots of sch work
    [XMOS_demo.kicad_sch, audio_out.kicad_sch, codec.kicad_sch, mcu.kicad_sch, psu.kicad_sch, usb.kicad_sch]
2026-04-04 sch work, pcb import and initial board outline
    [XMOS_demo.kicad_pcb, XMOS_demo.kicad_sch, audio_in.kicad_sch, audio_out.kicad_sch, codec.kicad_sch, mcu.kicad_sch, psu.kicad_sch, usb.kicad_sch]
2026-04-06 terminal block for power input added
    [XMOS_demo.kicad_pcb, usb.kicad_sch]
2026-04-11 sch mostly finished, needs tp, pcb component layout started
    [XMOS_demo.kicad_pcb, XMOS_demo.kicad_sch, audio_in.kicad_sch, audio_out.kicad_sch, codec.kicad_sch, mcu.kicad_sch, psu.kicad_sch, usb.kicad_sch]
2026-04-12 finished sch, pcb work
    [XMOS_demo.kicad_pcb, XMOS_demo.kicad_sch, audio_in.kicad_sch, audio_out.kicad_sch, codec.kicad_sch, mcu.kicad_sch, psu.kicad_sch, usb.kicad_sch]
2026-04-17 PCB work, changes for better routing
    [XMOS_demo.kicad_pcb, mcu.kicad_sch, psu.kicad_sch, usb.kicad_sch]
2026-05-03 sch work changes (jumpers, connectors, tp)
    [XMOS_demo.kicad_sch, audio_out.kicad_sch, codec.kicad_sch, mcu.kicad_sch, psu.kicad_sch, usb.kicad_sch]
2026-05-03 pcb routing
    [XMOS_demo.kicad_pcb, XMOS_demo.kicad_sch, audio_in.kicad_sch, codec.kicad_sch, mcu.kicad_sch, psu.kicad_sch]
2026-05-21 I2S config sch page added
    [XMOS_demo.kicad_sch, audio_in.kicad_sch, codec.kicad_sch, i2s_conf.kicad_sch, mcu.kicad_sch]
2026-06-09 Summary (required)
    [XMOS_demo.kicad_pcb, XMOS_demo.kicad_sch, audio_in.kicad_sch, audio_out.kicad_sch, codec.kicad_sch, i2s_conf.kicad_sch, mcu.kicad_sch, psu.kicad_sch]
2026-06-10 Started changes on power supply (audio in) on schematic
    [XMOS_demo.kicad_sch, audio_in.kicad_sch, audio_out.kicad_sch, codec.kicad_sch, i2s_conf.kicad_sch, mcu.kicad_sch, psu.kicad_sch, usb.kicad_sch]
2026-06-11 Passive lpf added to autio output
    [XMOS_demo.kicad_sch, audio_in.kicad_sch, audio_out.kicad_sch, codec.kicad_sch, i2s_conf.kicad_sch, mcu.kicad_sch, psu.kicad_sch, usb.kicad_sch]
2026-06-11 PCB work
    [XMOS_demo.kicad_pcb, audio_in.kicad_sch, audio_out.kicad_sch, codec.kicad_sch, i2s_conf.kicad_sch, mcu.kicad_sch, psu.kicad_sch, usb.kicad_sch]
2026-06-12 Changed flash to correct part
    [XMOS_demo.kicad_pcb, mcu.kicad_sch]
2026-06-14 routing work
    [XMOS_demo.kicad_pcb, audio_in.kicad_sch, mcu.kicad_sch, psu.kicad_sch]
2026-06-14 pdf documentation
    [XMOS_demo.kicad_pcb]
2026-08-15 xmos pcb work
    [XMOS_demo.kicad_pcb, psu.kicad_sch]
2026-09-06 sch and pcb changes - output filter
    [XMOS_demo.kicad_pcb, audio_out.kicad_sch]
2026-09-28 added simulation of ref dac output filter
2026-09-29 added schematic and simulation for active output filter
    [XMOS_demo.kicad_sch, audio_out.kicad_sch, out_filter.kicad_sch]
2026-09-29 Updated sch and pcb with active filter
    [XMOS_demo.kicad_pcb, XMOS_demo.kicad_sch, audio_out.kicad_sch, codec.kicad_sch, out_filter.kicad_sch]
2026-10-02 work on pcb layout, added active filter to dac out
    [XMOS_demo.kicad_pcb, audio_out.kicad_sch]
